syedalihassan006/Arduino-TDS-Sensor-Project/(list of files, drawings)

Other design files:
with_temperature/Proteus Simulation.pdsprj
without_temperature/Proteus_Simulation_No_TempSensor.pdsprj
