syedalihassan006/Arduino-TDS-Sensor-Project/data/TDS_Sensor_Results.xlsx

NaCl (g) | Theoretical (ppm) | Arduino Sensor (ppm) | Commercial Sensor (ppm)
0 | 0 | 3 | 0
0.1 | 50 | 49 | 50
0.2 | 100 | 105 | 96
0.3 | 150 | 152 | 149
0.4 | 200 | 199 | 201
0.5 | 250 | 249 | 247
0.6 | 300 | 312 | 303
0.7 | 350 | 356 | 344
0.8 | 400 | 397 | 398
0.9 | 450 | 454 | 441
1 | 500 | 497 | 518
1.1 | 550 | 547 | 550
1.2 | 600 | 601 | 597
1.3 | 650 | 643 | 658
1.4 | 700 | 698 | 698
1.5 | 750 | 737 | 731
1.6 | 800 | 792 | 799
1.7 | 850 | 852 | 847
1.8 | 900 | 893 | 901
1.9 | 950 | 939 | 957
2 | 1000 | 977 | 1008
