syedalihassan006/Arduino-TDS-Sensor-Project/data/PairedtTest.xlsx

 | Variable 1 | Variable 2
Mean | 497.7142857 | 499.6666667
Variance | 93097.21429 | 96832.03333
Observations | 21 | 21
Pearson Correlation | 0.9995159218
Hypothesized Mean Difference | 0
df | 20
t Stat | -0.7888116805
P(T<=t) one-tail | 0.2197365735
t Critical one-tail | 1.724718243
P(T<=t) two-tail | 0.864216899
t Critical two-tail | 2.085963447
