syedalihassan006/Arduino-TDS-Sensor-Project/(notices)

Notices in the files:
README.md:
License: MIT
